AlanFord/ArduinoMega6axis/hardware/IMG_8536 copy.JPG

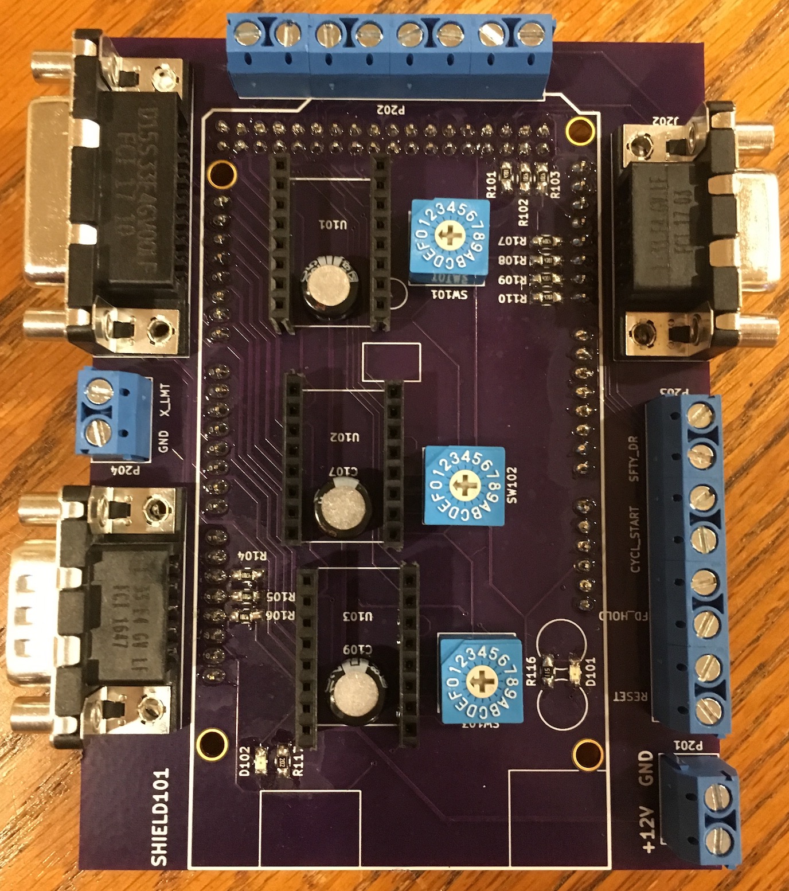
hardware/IMG_8536 copy.JPG
