AlanFord/ArduinoMega6axis/README.md

# ArduinoMega6axis
A stepper motor control shield for an Arduino Mega that will support 3 primary off-board motor controllers and 3 on-board Pololu A4988 controllers.  This supports work done at Build,RVA (http://rvabuild.com) to construct a Robot Arm (see http://fablab.ruc.dk/robot-arm-v-0-1/ ).
