AlanFord/ArduinoMega6axis/references/stepper-drivers/22144522.jpg

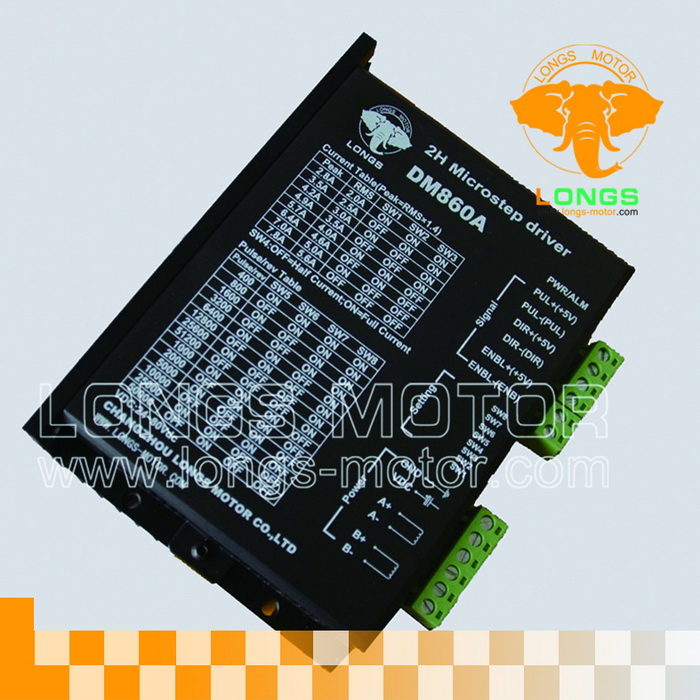
references/stepper-drivers/22144522.jpg
