AlanFord/ArduinoMega6axis/ArduinoMegaShield.pdf

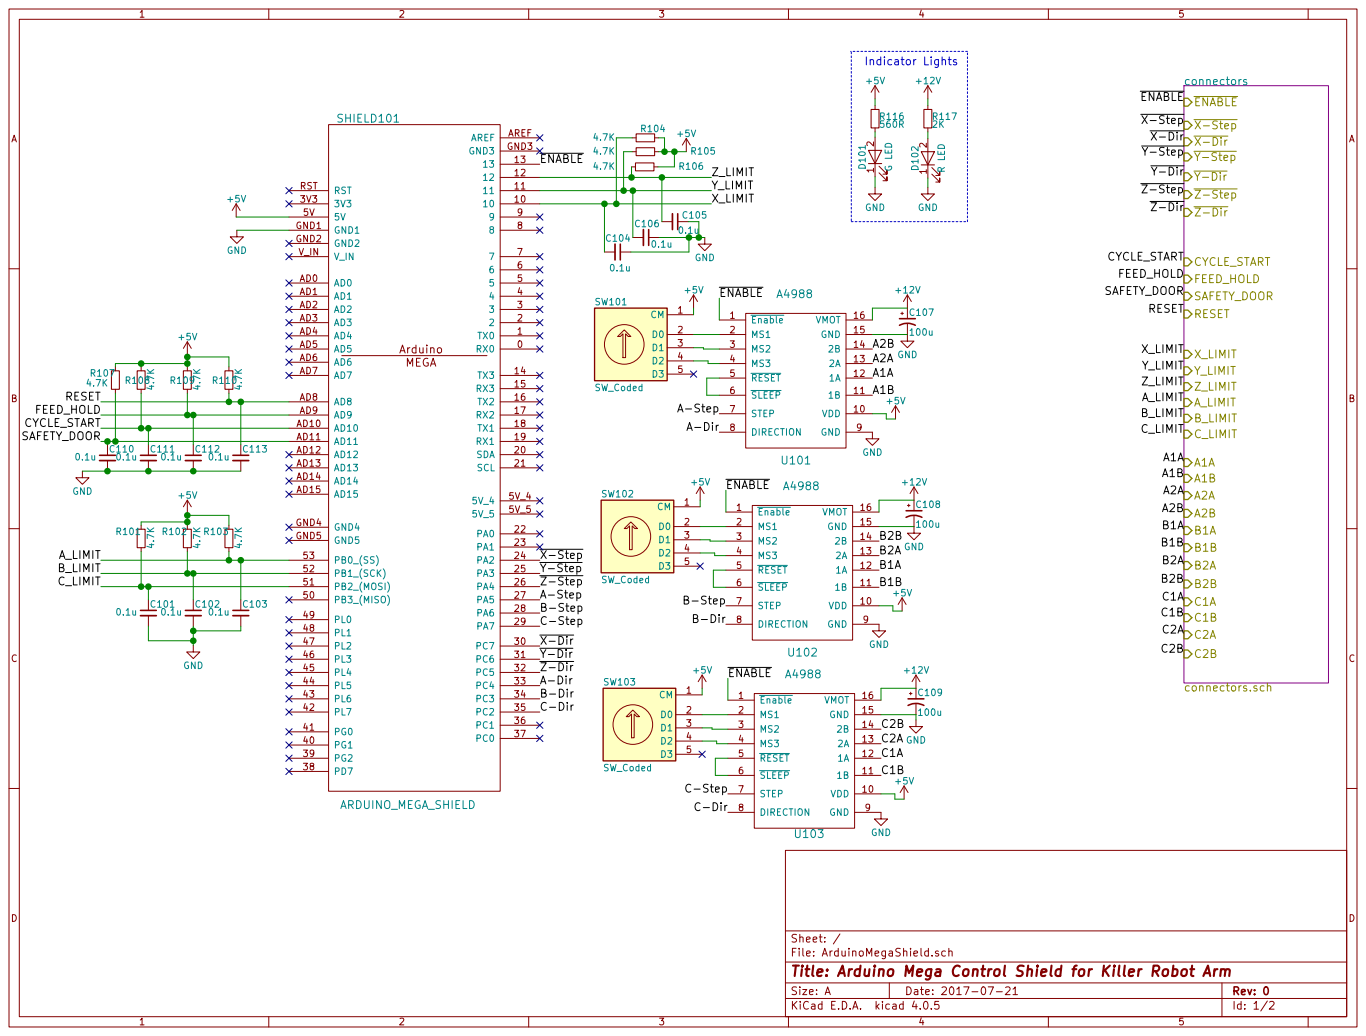
[picture p6: page 1]

connectors
ENABLE
X-Step X-Dir Y-Step Y-Dir Z-Step Z-Dir CYCLE_START

Z-Step X-Dir Y-Dir Z-Dir ENABLE

File: ArduinoMegaShield.sch Sheet: /
Id: 1/2 Title: Arduino Mega Control Shield for Killer Robot Arm

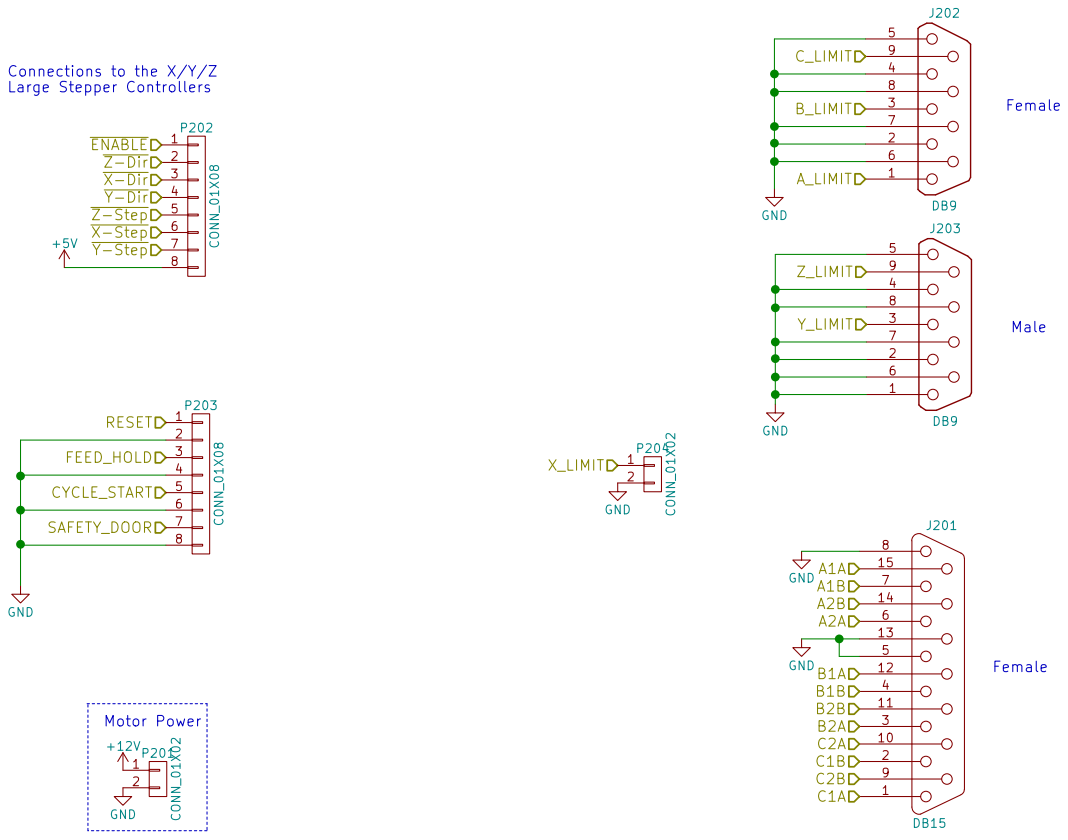
[picture p7: page 2]
