AlanFord/ArduinoMega6axis/hardware/ArduinoMegaShield.kicad_pcb

## KiCad design hardware/ArduinoMegaShield.kicad_pcb (2017-08-30)

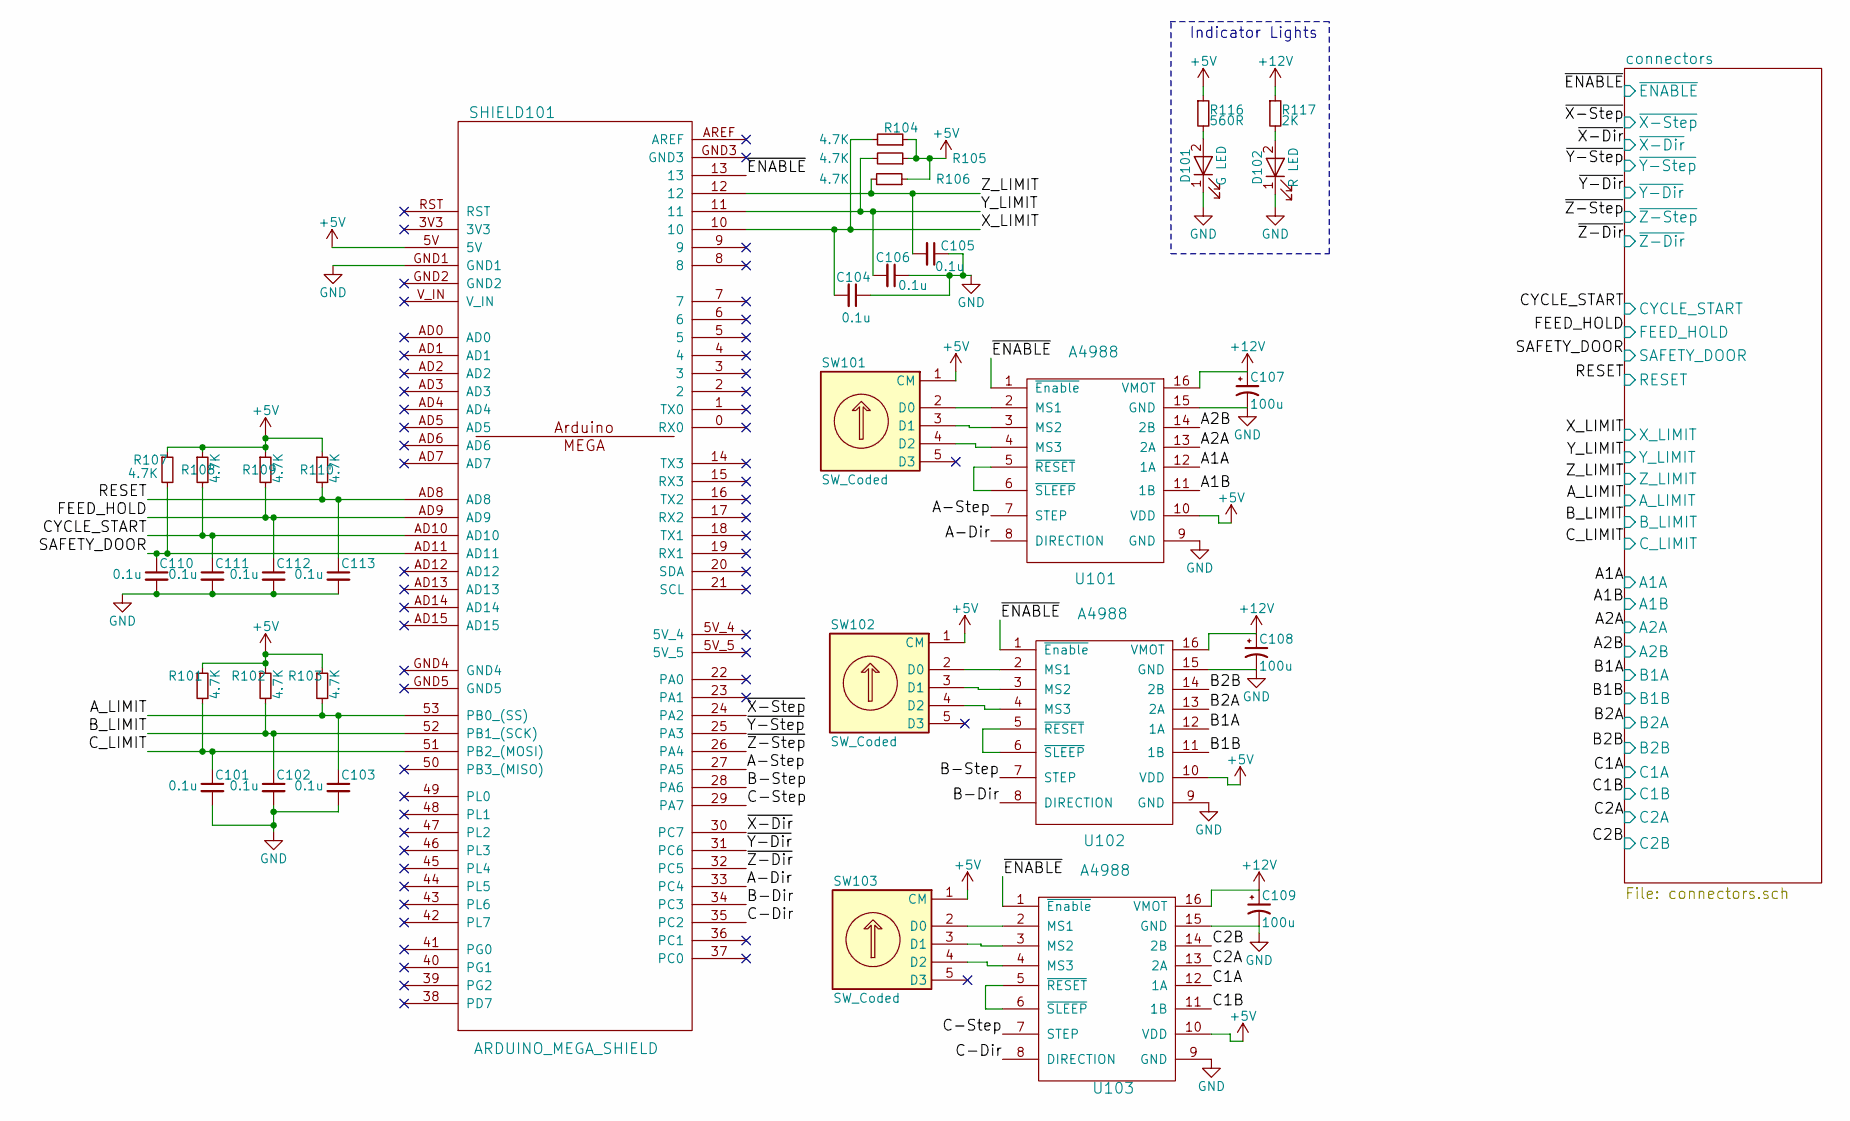
[picture p8: schematic ArduinoMegaShield.sch, Arduino Mega Control Shield for Killer Robot Arm]

Parts:
C101, C102, C103, C104, C105, C106, C110, C111, C112, C113: 0.1u; C_0805_HandSoldering
C107, C108, C109: 100u; C_Radial_D6.3_L11.2_P2.5; MPN EEU-FM1E101
D101: G LED; LED_0805
D102: R LED; LED_0805
R101, R102, R103, R104, R105, R106, R107, R108, R109, R110: 4.7K; R_0805_HandSoldering
R116: 560R; R_0805_HandSoldering
R117: 2K; R_0805_HandSoldering
SHIELD101: ARDUINO_MEGA_SHIELD
SW101, SW102, SW103: SW_Coded; S-1010A; MPN Copal S-1010A
U101, U102, U103: A4988

Connections:
+5V: R101.1, R102.1, R103.1, R104.1, R105.1, R106.1, R107.1, R108.1, R109.1, R110.1, R116.1, SHIELD101.5V, SW101.1 (CM), SW102.1 (CM), SW103.1 (CM), U101.10 (VDD), U102.10 (VDD), U103.10 (VDD); also elsewhere on the board
+12V: C107.1, C108.1, C109.1, R117.1, U101.16 (VMOT), U102.16 (VMOT), U103.16 (VMOT); also elsewhere on the board
/A1A: U101.12 (1A); also elsewhere on the board
/A1B: U101.11 (1B); also elsewhere on the board
/A2A: U101.13 (2A); also elsewhere on the board
/A2B: U101.14 (2B); also elsewhere on the board
/A-Dir: SHIELD101.33 (PC4), U101.8 (DIRECTION)
/A-Step: SHIELD101.27 (PA5), U101.7 (STEP)
/A_LIMIT: C103.1, R103.2, SHIELD101.53 (PB0_(SS)); also elsewhere on the board
/B1A: U102.12 (1A); also elsewhere on the board
/B1B: U102.11 (1B); also elsewhere on the board
/B2A: U102.13 (2A); also elsewhere on the board
/B2B: U102.14 (2B); also elsewhere on the board
/B-Dir: SHIELD101.34 (PC3), U102.8 (DIRECTION)
/B-Step: SHIELD101.28 (PA6), U102.7 (STEP)
/B_LIMIT: C102.1, R102.2, SHIELD101.52 (PB1_(SCK)); also elsewhere on the board
/C1A: U103.12 (1A); also elsewhere on the board
/C1B: U103.11 (1B); also elsewhere on the board
/C2A: U103.13 (2A); also elsewhere on the board
/C2B: U103.14 (2B); also elsewhere on the board
/C-Dir: SHIELD101.35 (PC2), U103.8 (DIRECTION)
/C-Step: SHIELD101.29 (PA7), U103.7 (STEP)
/CYCLE_START: C111.1, R108.2, SHIELD101.AD10; also elsewhere on the board
/C_LIMIT: C101.1, R101.2, SHIELD101.51 (PB2_(MOSI)); also elsewhere on the board
/FEED_HOLD: C112.1, R109.2, SHIELD101.AD9; also elsewhere on the board
/RESET: C113.1, R110.2, SHIELD101.AD8; also elsewhere on the board
/SAFETY_DOOR: C110.1, R107.2, SHIELD101.AD11; also elsewhere on the board
/X_LIMIT: C104.2, R104.2, SHIELD101.10; also elsewhere on the board
/Y_LIMIT: C106.2, R105.2, SHIELD101.11; also elsewhere on the board
/Z_LIMIT: C105.2, R106.2, SHIELD101.12; also elsewhere on the board
/~ENABLE: SHIELD101.13, U101.1 (~Enable), U102.1 (~Enable), U103.1 (~Enable); also elsewhere on the board
/~X-Dir: SHIELD101.30 (PC7); also elsewhere on the board
/~X-Step: SHIELD101.24 (PA2); also elsewhere on the board
/~Y-Dir: SHIELD101.31 (PC6); also elsewhere on the board
/~Y-Step: SHIELD101.25 (PA3); also elsewhere on the board
/~Z-Dir: SHIELD101.32 (PC5); also elsewhere on the board
/~Z-Step: SHIELD101.26 (PA4); also elsewhere on the board
GND: C101.2, C102.2, C103.2, C104.1, C105.1, C106.1, C107.2, C108.2, C109.2, C110.2, C111.2, C112.2, C113.2, D101.1 (K), D102.1 (K), SHIELD101.GND1, U101.9 (GND), U101.15 (GND), U102.9 (GND), U102.15 (GND), U103.9 (GND), U103.15 (GND); also elsewhere on the board
unnamed: D101.2 (A), R116.2
unnamed: D102.2 (A), R117.2
unnamed: SW101.2 (D0), U101.2 (MS1)
unnamed: SW101.3 (D1), U101.3 (MS2)
unnamed: SW101.4 (D2), U101.4 (MS3)
unnamed: SW102.2 (D0), U102.2 (MS1)
unnamed: SW102.3 (D1), U102.3 (MS2)
unnamed: SW102.4 (D2), U102.4 (MS3)
unnamed: SW103.2 (D0), U103.2 (MS1)
unnamed: SW103.3 (D1), U103.3 (MS2)
unnamed: SW103.4 (D2), U103.4 (MS3)
unnamed: U101.5 (~RESET), U101.6 (~SLEEP)
unnamed: U102.5 (~RESET), U102.6 (~SLEEP)
unnamed: U103.5 (~RESET), U103.6 (~SLEEP)

Notes on the sheet:
Indicator Lights

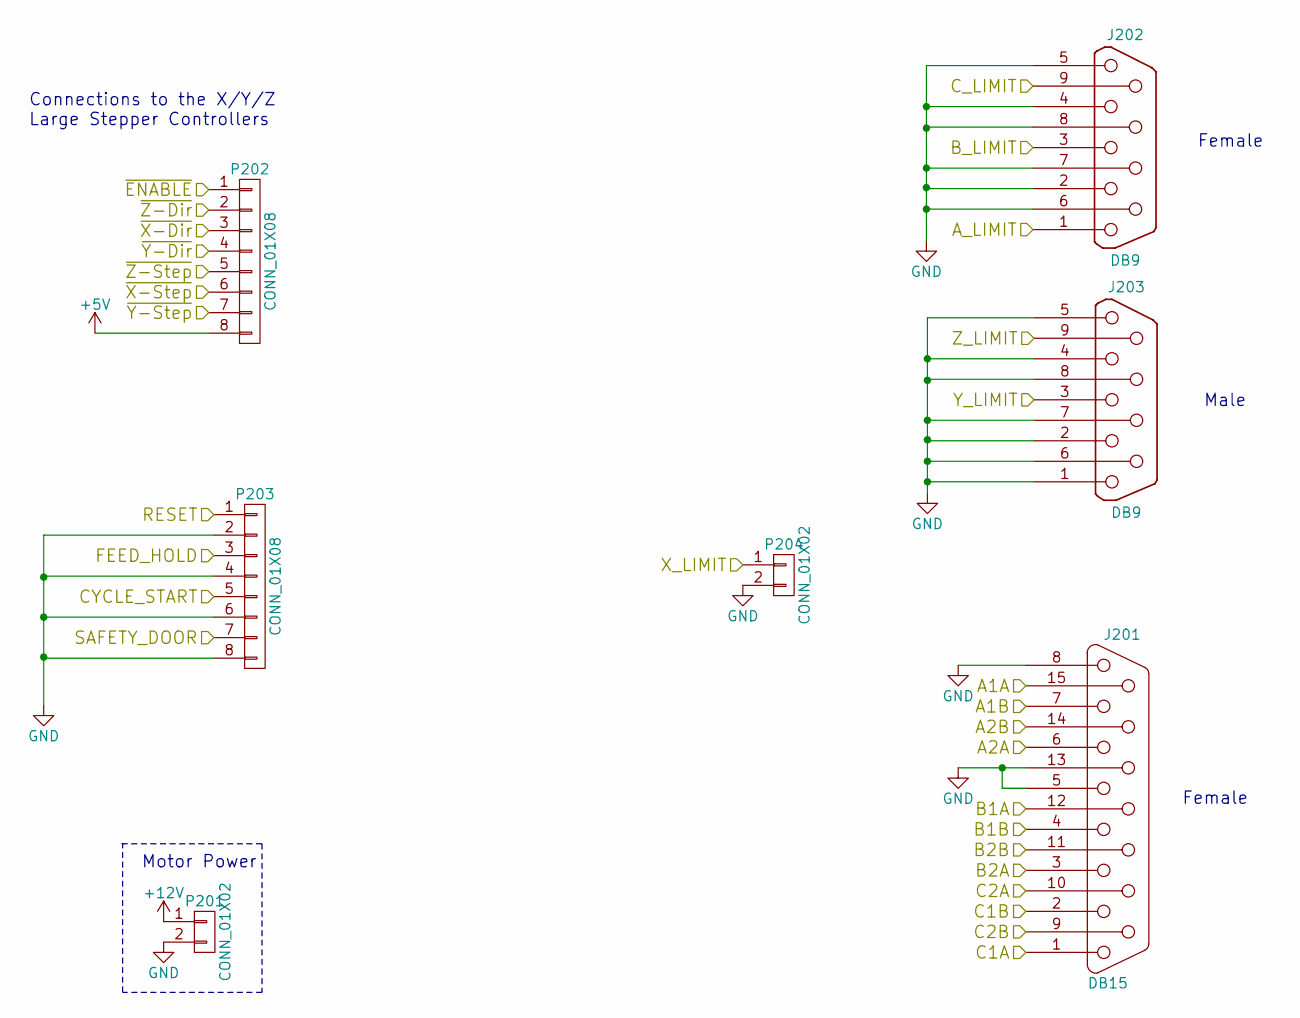
[picture p9: schematic connectors.sch]

Parts:
J201: DB15; D15S33E4GV00LF; MPN D15S33E4GV00LF
J202: DB9; LD09S33E4GV00LF; MPN LD09S33E4GV00LF
J203: DB9; LD09P33E4GV00LF; MPN LD09P33E4GV00LF
P201, P204: CONN_01X02; Terminal_Block_200_mil; MPN OSTTC022162
P202, P203: CONN_01X08; Terminal_Block_200_mil_8pos; MPN OSTTC022162

Connections:
+5V: P202.8; also elsewhere on the board
+12V: P201.1; also elsewhere on the board
/A1A: J201.15; also elsewhere on the board
/A1B: J201.7; also elsewhere on the board
/A2A: J201.6; also elsewhere on the board
/A2B: J201.14; also elsewhere on the board
/A_LIMIT: J202.1; also elsewhere on the board
/B1A: J201.12; also elsewhere on the board
/B1B: J201.4; also elsewhere on the board
/B2A: J201.3; also elsewhere on the board
/B2B: J201.11 (P111); also elsewhere on the board
/B_LIMIT: J202.3; also elsewhere on the board
/C1A: J201.1; also elsewhere on the board
/C1B: J201.2; also elsewhere on the board
/C2A: J201.10; also elsewhere on the board
/C2B: J201.9; also elsewhere on the board
/CYCLE_START: P203.5; also elsewhere on the board
/C_LIMIT: J202.9; also elsewhere on the board
/FEED_HOLD: P203.3; also elsewhere on the board
/RESET: P203.1; also elsewhere on the board
/SAFETY_DOOR: P203.7; also elsewhere on the board
/X_LIMIT: P204.1; also elsewhere on the board
/Y_LIMIT: J203.3; also elsewhere on the board
/Z_LIMIT: J203.9; also elsewhere on the board
/~ENABLE: P202.1; also elsewhere on the board
/~X-Dir: P202.3; also elsewhere on the board
/~X-Step: P202.6; also elsewhere on the board
/~Y-Dir: P202.4; also elsewhere on the board
/~Y-Step: P202.7; also elsewhere on the board
/~Z-Dir: P202.2; also elsewhere on the board
/~Z-Step: P202.5; also elsewhere on the board
GND: J201.5, J201.8, J201.13, J202.2, J202.4, J202.5, J202.6, J202.7, J202.8, J203.1, J203.2, J203.4, J203.5, J203.6, J203.7, J203.8, P201.2, P203.2, P203.4, P203.6, P203.8, P204.2; also elsewhere on the board

Notes on the sheet:
Motor Power
Connections to the X/Y/Z Large Stepper Controllers
Female
Male

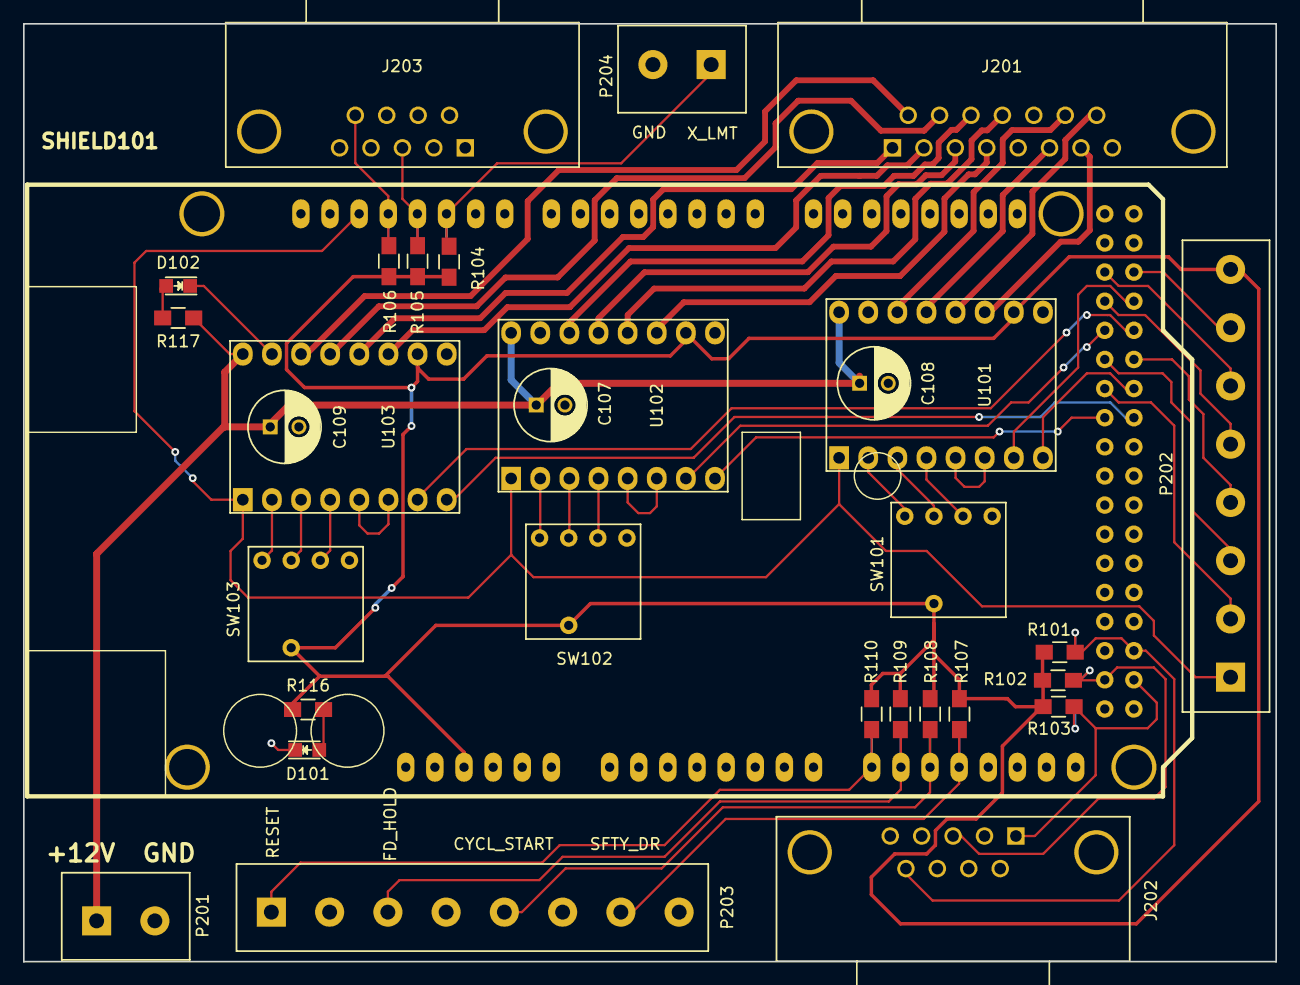
[picture p10: board ArduinoMegaShield.kicad_pcb from above]

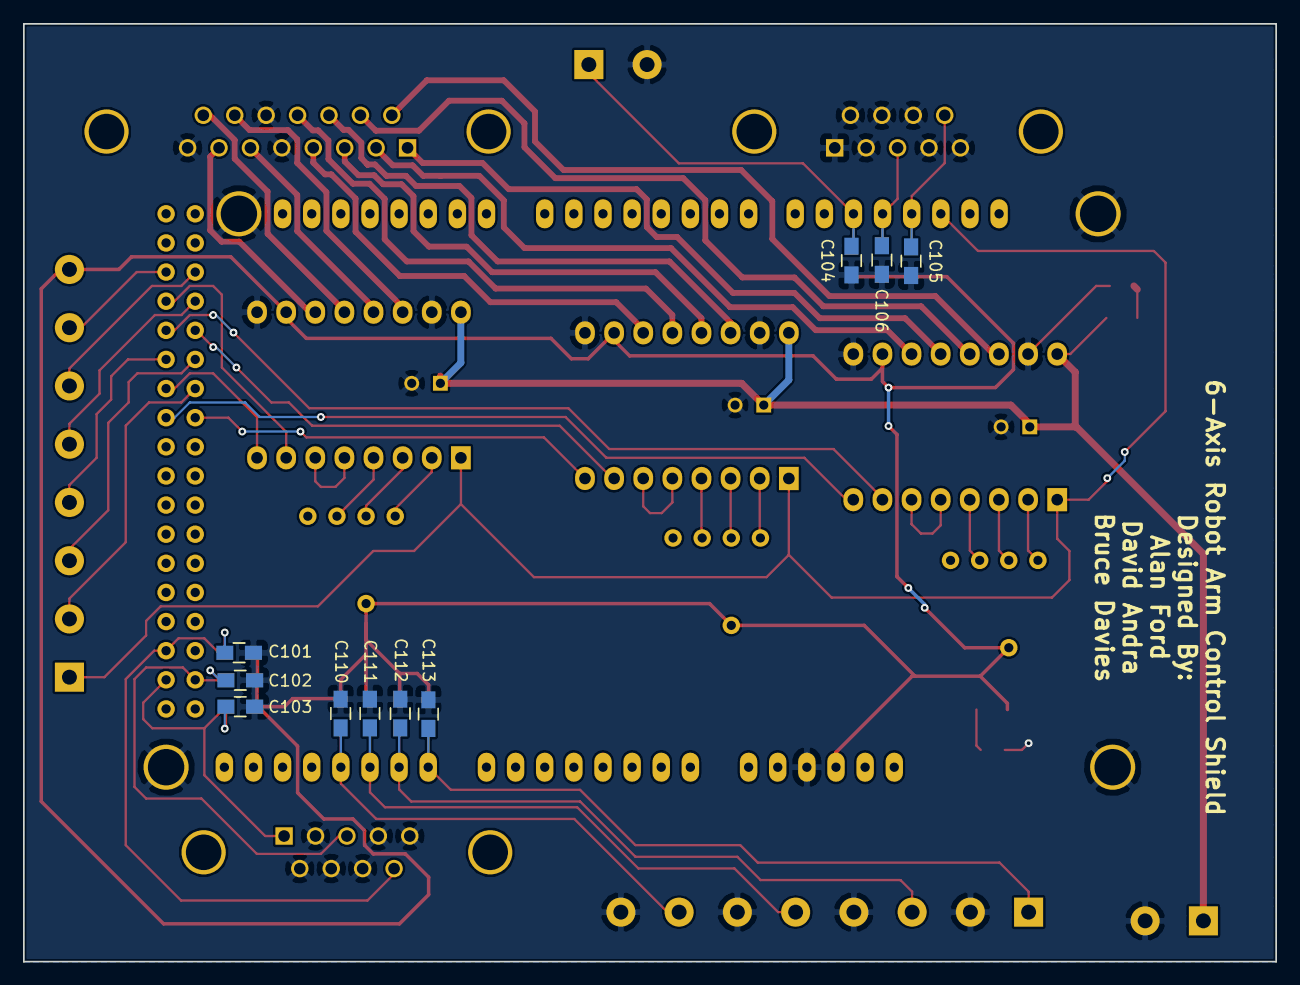
[picture p11: board ArduinoMegaShield.kicad_pcb from below]

Board: 2 copper layers, 109.2 x 81.8 mm, 41 parts (10 on the bottom side), 52 nets.
