AlanFord/ArduinoMega6axis/(commit log)

2017-07-21 initial cut at schematic
    [ArduinoMegaShield.kicad_pcb, ArduinoMegaShield.sch]
2017-07-21 generated a pdf of the schematic
2017-07-22 added microstepping NOPOP resistors and power indicator LEDs. Assigned some footprints
    [ArduinoMegaShield.sch]
2017-07-22 updated schematic pdf
2017-07-22 correctly logic of steps/dir on shield output pins
    [ArduinoMegaShield.sch]
2017-07-22 initiated pcb layout
    [ArduinoMegaShield.kicad_pcb]
2017-07-22 changed terminal connectors from dupont to 200 mil screw terminals
    [ArduinoMegaShield.kicad_pcb, ArduinoMegaShield.sch]
2017-07-22 added footprints for caps and motor drivers
    [ArduinoMegaShield.kicad_pcb, ArduinoMegaShield.sch]
2017-07-22 added terminal connections for limit switches
    [ArduinoMegaShield.kicad_pcb, ArduinoMegaShield.sch]
2017-07-22 added note about limit switches being on a single bank/port
    [ArduinoMegaShield.sch]
2017-07-23 added NOPOPs for optional pullups on limit switches
    [ArduinoMegaShield.kicad_pcb, ArduinoMegaShield.sch]
2017-07-31 added caps to the limit switches
    [ArduinoMegaShield.sch]
2017-08-02 added estop on the avr reset pin
    [ArduinoMegaShield.sch]
2017-08-02 added safety-door switch as a halt-but-don't-downpower option
    [ArduinoMegaShield.sch]
2017-08-07 changed pull down resistor to 4.7k and added note about rotary dip switch
    [ArduinoMegaShield.sch]
2017-08-09 wired ~SLEEP and ~RESET together on small stepper drivers
    [ArduinoMegaShield.sch]
2017-08-20 added switches for cycle_start and feed_hold, added docs for protoboard mockup
    [ArduinoMegaShield.sch, board layouts.xlsx]
2017-08-23 moved connectors to separate sheet and started board layout
    [ArduinoMegaShield.kicad_pcb, ArduinoMegaShield.sch, connectors.sch]
2017-08-25 changed connector footprints and added rotory dip switch footprint
    [ArduinoMegaShield.kicad_pcb, ArduinoMegaShield.sch, connectors.sch]
2017-08-29 changed dsub connectors to horizontal
    [ArduinoMegaShield.kicad_pcb, ArduinoMegaShield.sch, connectors.sch]
2017-08-30 completed board and generated gerbers
    [ArduinoMegaShield-B.Cu.gbl, ArduinoMegaShield-B.Mask.gbs, ArduinoMegaShield-B.SilkS.gbo, ArduinoMegaShield-Edge.Cuts.gm1, ArduinoMegaShield-F.Cu.gtl, ArduinoMegaShield-F.Mask.gts, ArduinoMegaShield-F.SilkS.gto, ArduinoMegaShield.drl]
