AlanFord/ArduinoMega6axis/hardware/IMG_8536.JPG

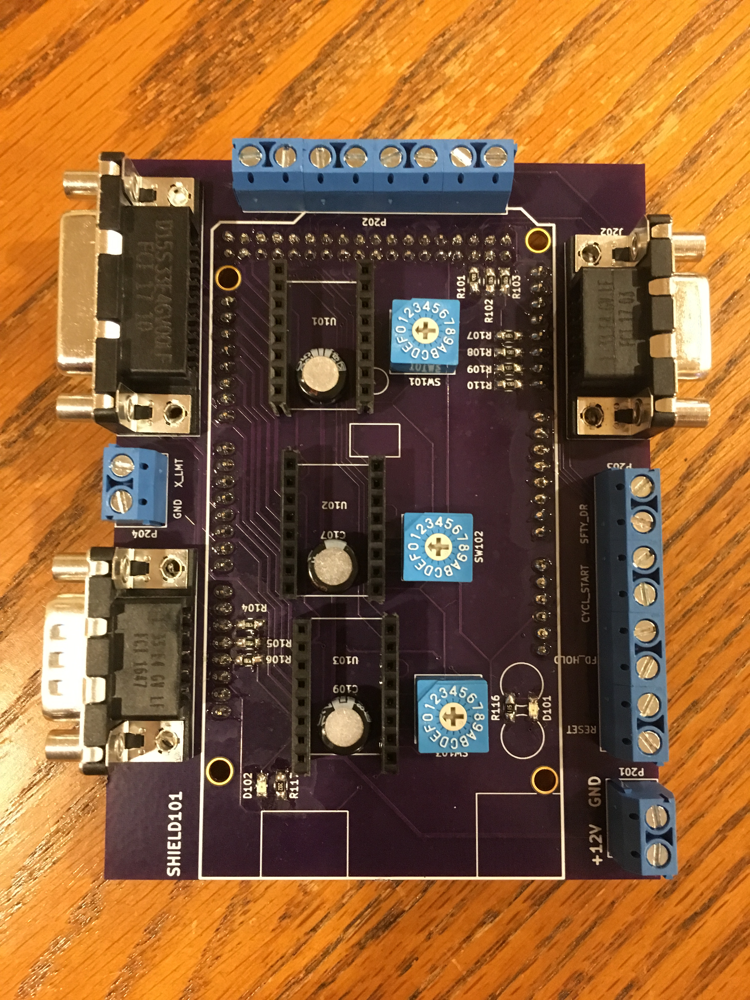
hardware/IMG_8536.JPG
